frootloop69/pegboard-accessories-openscad/README.md

# Pegboard Accessories OpenSCAD

Parametric OpenSCAD tooling for designing 3D-printable pegboard accessories for the workshop and 3D-printer racks.

## Project goals

- One reusable pegboard mounting interface per physical board type.
- Calibrate the mounting interface on real hardware before building tool holders.
- Keep tool-holder geometry separate from pegboard mounting geometry.
- Generate holders from measurable dimensions rather than hand-editing STLs.
- Maintain physical test results and hardware presets in source control.
- Align production accessory bottoms with the mount backplate bottom wherever
  practical to minimize support material.

## Current hardware presets

| Preset | Pitch | Peg diameter | Status |
|---|---:|---:|---|
| `EUREKA_WORKSPACE` | 25.4 mm | **5.2 mm** | Validated with Creality Hyper PLA, standard orientation |
| `SPAMPUR_PRINTER` | 25.4 mm | TBD | 5.8 mm fits easily; 6.2 mm is still loose; 6.8/6.9/7.0 mm calibration pending |

Common retained geometry:

- hook offset: 4.5 mm
- hook neck: 0.5 mm
- reference `board_thickness` geometry parameter: 5.0 mm

The 5.0 mm value is an empirical geometry parameter inherited from the proven reference design; it is **not** a statement that the metal pegboard sheet is physically 5 mm thick.

## Repository layout

- `src/` — reusable parametric OpenSCAD modules, board presets, and shared U-holder geometry
- `calibration/` — source for physical fit-test coupons
- `examples/` — tool-holder examples built on the common mount interface
- `docs/` — board presets, test results, design notes, and third-party references

Generated STL files are intentionally not tracked. Render them from the corresponding `.scad` source so the source remains authoritative.

## Development rule

**Do not build tool-specific holders on an unvalidated mount.**

Mount calibration is authoritative: dimensions are updated from actual printed fit tests on the physical boards.

## Current calibration state

### Eureka workspace pegboard
- 5.8 mm: too large in the earlier calibration series
- 5.5 mm: fit perfectly with the earlier filament/process
- **5.2 mm: validated with Creality Hyper PLA in the standard production orientation**
- Current production default: **5.2 mm**
- Peg diameter is treated as material/process-sensitive

### Spampur printer-rack pegboard
- 5.8 mm: fits easily / has room to increase
- 6.2 mm: still loose
- 6.8 mm: pending test
- 6.9 mm: pending test
- 7.0 mm: pending test
- Current default: **not yet locked**

## OpenSCAD

The project is intended to work with the normal OpenSCAD desktop application. Generated calibration parts should always be printed at 100% scale.

## Current accessories

### Eureka workspace driver station

The first production accessory is a modular electronics-workbench driver
station. It includes:

- three-hole handle-support screwdriver rack
- optional lower guide for the two long drivers (fallback)
- full-size ratchet drop-through holder with adjacent bit-caddy pocket
- Stanley stubby ratchet drop-through holder

Measured tool dimensions, physical test results, and V2 clearances are documented in
`docs/DRIVER_STATION.md`.

### Shared U-holder geometry

`src/u_holder.scad` contains reusable U-slot, contact-chamfer, root-fillet,
and rounded-end shelf primitives. New pegboard accessories should use these
helpers rather than reimplementing U-shaped tool supports.

## Print-orientation design rule

Production accessories should normally share their lowest front-feature plane
with the bottom edge of the common mounting backplate. Use
`pegboard_feature_top_z()` from `src/mount.scad` rather than hard-coding a
vertical offset. Functional requirements may override this, but unnecessary
air gaps should not be designed into new holders.

## Production print orientation

Production example SCAD files now export in the intended print orientation:
horizontal accessory features remain parallel to XY and the common
backplate/accessory bottom is translated to Z=0. Do not reintroduce the old
90-degree side-print rotation unless a particular future accessory explicitly
requires it.

## OpenSCAD Customizer-ready accessory scripts

The production accessory files in `examples/` expose their practical tuning
parameters directly in the OpenSCAD Customizer. Open a production example and
choose **Window -> Customizer**.

Current Customizer-ready files:

- `examples/eureka_fixed_driver_rack.scad`
- `examples/eureka_full_ratchet_with_bits.scad`
- `examples/eureka_long_driver_lower_guide.scad`
- `examples/eureka_stubby_ratchet.scad`

Each file includes a parameter guide at the top and grouped controls for mount
calibration, tool fit, geometry, positioning, and edge treatment. The example
files are intended to be the normal user-facing place to tune dimensions;
`src/driver_station.scad` remains the reusable implementation.
