frootloop69/pegboard-accessories-openscad/examples/README.md

# Examples

Tool-specific example holders will be added after the common mount API is finalized.
