frootloop69/pegboard-accessories-openscad/calibration/driver_station_fit_coupon.scad

use <../src/driver_station.scad>

// Tool-interface coupon only. Print flat at 100% scale before committing to
// the larger driver-station pieces. V2 validates the 20/21.5/6.9 mm fixed\n// driver support holes; the 30/33 mm ratchet holes have already been tested.
driver_station_fit_coupon();
