frootloop69/pegboard-accessories-openscad/calibration/eureka_5p2_hyper_pla.scad

/*
  Validated Eureka workspace calibration:
  Creality Hyper PLA, repository-standard axis-aligned print orientation.
*/

use <default_mount_coupon.scad>

mount_calibration_coupon(peg_d=5.2);
