frootloop69/pegboard-accessories-openscad/calibration/eureka_5p5.scad

use <default_mount_coupon.scad>

mount_calibration_coupon(peg_d=5.5);
