frootloop69/pegboard-accessories-openscad/calibration/spampur_6p2.scad

use <default_mount_coupon.scad>

mount_calibration_coupon(peg_d=6.2);
