frootloop69/pegboard-accessories-openscad/calibration/spampur_7p0.scad

use <default_mount_coupon.scad>

mount_calibration_coupon(peg_d=7.0);
