frootloop69/pegboard-accessories-openscad/(list of files, cad)

Other CAD files:
calibration/driver_station_u_slot_coupon.scad
examples/eureka_stubby_ratchet.scad
