frootloop69/pegboard-accessories-openscad/(commit log)

2026-09-20 Document project scope and current calibration state
2026-09-20 Add docs/BOARD_PRESETS.md
2026-09-20 Add src/presets.scad
    [presets.scad]
2026-09-20 Add calibration/default_mount_coupon.scad
    [default_mount_coupon.scad]
2026-09-20 Ignore generated STL artifacts
2026-09-20 Refactor calibration coupon to reusable mount module
    [default_mount_coupon.scad]
2026-09-20 Add reusable pegboard mount module
    [mount.scad]
2026-09-20 Add calibration/eureka_5p5.scad
    [eureka_5p5.scad]
2026-09-20 Add calibration/spampur_6p1.scad
    [spampur_6p1.scad]
2026-09-20 Add calibration/spampur_6p2.scad
    [spampur_6p2.scad]
2026-09-20 Add calibration/README.md
2026-09-20 Add modular Eureka driver station
    [driver_station.scad]
2026-09-20 Document Eureka driver station V1
2026-09-20 Add driver station fit coupon
    [driver_station_fit_coupon.scad]
2026-09-20 Add Eureka fixed driver rack example
    [eureka_fixed_driver_rack.scad]
2026-09-20 Add Eureka long-driver guide example
    [eureka_long_driver_lower_guide.scad]
2026-09-20 Add Eureka full ratchet holder example
    [eureka_full_ratchet_with_bits.scad]
2026-09-20 Add Eureka stubby ratchet holder example
    [eureka_stubby_ratchet.scad]
2026-09-20 Document driver station in README
2026-09-20 Record driver station V1
2026-09-21 Revise fixed drivers to handle-support holes
    [driver_station.scad]
2026-09-21 Document V2 driver support holes
2026-09-21 Update driver station summary for V2
2026-09-21 Record physical driver coupon results
2026-09-21 Update fit coupon notes for V2
    [driver_station_fit_coupon.scad]
2026-09-21 Separate V2 fit coupon holes
    [driver_station.scad]
2026-09-21 Add all-driver U-slot fit coupon
    [driver_station.scad]
2026-09-21 Add U-slot driver calibration coupon
    [driver_station_u_slot_coupon.scad]
2026-09-21 Document U-slot comparison test
2026-09-21 Record U-slot coupon addition
2026-09-21 Record Spampur 6.2 mm loose fit
2026-09-21 Update Spampur calibration bracket
2026-09-21 Record Spampur 6.2 mm test result
2026-09-21 Advance provisional Spampur calibration value
    [presets.scad]
2026-09-21 Add Spampur 6.8 mm calibration coupon
    [spampur_6p8.scad]
2026-09-21 Add Spampur 6.9 mm calibration coupon
    [spampur_6p9.scad]
2026-09-21 Add Spampur 7.0 mm calibration coupon
    [spampur_7p0.scad]
2026-09-21 Adopt tested U-slot geometry for all drivers
    [driver_station.scad]
2026-09-21 Document successful U-slot driver test
2026-09-21 Record V3 U-slot driver geometry
2026-09-21 Update Phillips U-slot coupon size to 22 mm
    [driver_station_u_slot_coupon.scad]
2026-09-21 Round stubby U ends and add shelf root fillet
    [driver_station.scad]
2026-09-21 Add stubby U-slot contact chamfer
    [driver_station.scad]
2026-09-21 Record stubby U-slot contact chamfer
2026-09-21 Generalize U-holder fillet and contact chamfer
    [driver_station.scad]
2026-09-21 Add reusable U-holder finishing primitives
    [u_holder.scad]
2026-09-21 Use shared U-holder geometry library
    [driver_station.scad]
2026-09-21 Remove excess material from full ratchet holder
    [driver_station.scad]
2026-09-21 Document full ratchet material reduction
2026-09-21 Record full ratchet material reduction
2026-09-21 Align bit caddy bottom with ratchet U
    [driver_station.scad]
2026-09-21 Align caddy pocket with backplate edge
    [driver_station.scad]
2026-09-21 Reduce bit caddy front lip to 1.5 mm
    [driver_station.scad]
2026-09-21 Fillet caddy side-wall front edges
    [driver_station.scad]
2026-09-21 Add mount alignment helpers for print-efficient accessories
    [mount.scad]
2026-09-21 Align accessory bottoms with mount backplate
    [driver_station.scad]
2026-09-21 Add print-efficient bottom-alignment design rule
2026-09-21 Document driver station bottom alignment
2026-09-21 Use axis-aligned production print orientation
    [eureka_fixed_driver_rack.scad]
2026-09-21 Add production print-axis rule
2026-09-21 Document production print orientation
2026-09-21 Reduce full ratchet U-slot to 27 mm
    [driver_station.scad]
2026-09-21 Document 27 mm ratchet support
2026-09-21 Record ratchet U-slot reduction
2026-09-21 Update ratchet calibration label to 27 mm
    [driver_station_u_slot_coupon.scad]
2026-09-21 Match mount coupon to production print orientation
    [default_mount_coupon.scad]
2026-09-21 Add editable Eureka mount tuning coupon
    [eureka_mount_tuning.scad]
2026-09-21 Refactor mount coupon to parameterized module
    [default_mount_coupon.scad]
2026-09-21 Fix tuning coupon parameter warnings
    [eureka_mount_tuning.scad]
2026-09-21 Use parameterized mount calibration coupon
    [eureka_5p5.scad]
2026-09-21 Set Eureka Hyper PLA peg diameter to 5.2 mm
    [presets.scad]
2026-09-21 Set Eureka tuning default to 5.2 mm
    [eureka_mount_tuning.scad]
2026-09-21 Document Eureka Hyper PLA calibration
2026-09-21 Log Eureka 5.2 mm Hyper PLA validation
2026-09-21 Update Eureka production calibration to 5.2 mm
2026-09-21 Record Hyper PLA Eureka calibration
2026-09-21 Update driver station for 5.2 mm Eureka preset
2026-09-21 Add validated Eureka Hyper PLA coupon
    [eureka_5p2_hyper_pla.scad]
2026-09-21 Expose accessory fit dimensions as module parameters
    [driver_station.scad]
2026-09-21 Fix exposed accessory parameter defaults
    [driver_station.scad]
2026-09-21 Make accessory example Customizer-ready
    [eureka_fixed_driver_rack.scad]
